trgzng1802/LED-CUB-8x8x8-using-STM32/README.md

# LED-CUB-8x8x8-using-STM32
Đề tài báo cáo cuối khoá C22
Ngày báo cáo: 19/06/2022

************************
Folder: "altium" chứa file schematic của CUBE.
Folder: "code ledcube" chứa toàn bộ code + config của CUBE.
Folder: "code stm32f0" + "test 74hc595" chứa file code + config test SN74HC595N.
Folder: "proteus" chứa file mô phỏng.

************************
GamoLedCube là tool mô phỏng cube.
