trgzng1802/LED-CUB-8x8x8-using-STM32/board.DXF

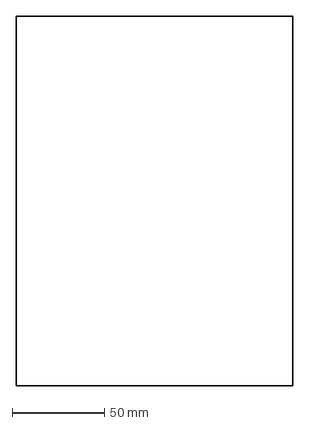
[picture p3: CAD file, 2022-07-10]
board.DXF
150.0 x 200.0 mm
