trgzng1802/LED-CUB-8x8x8-using-STM32/altium/schematic_board_ledcube.pdf

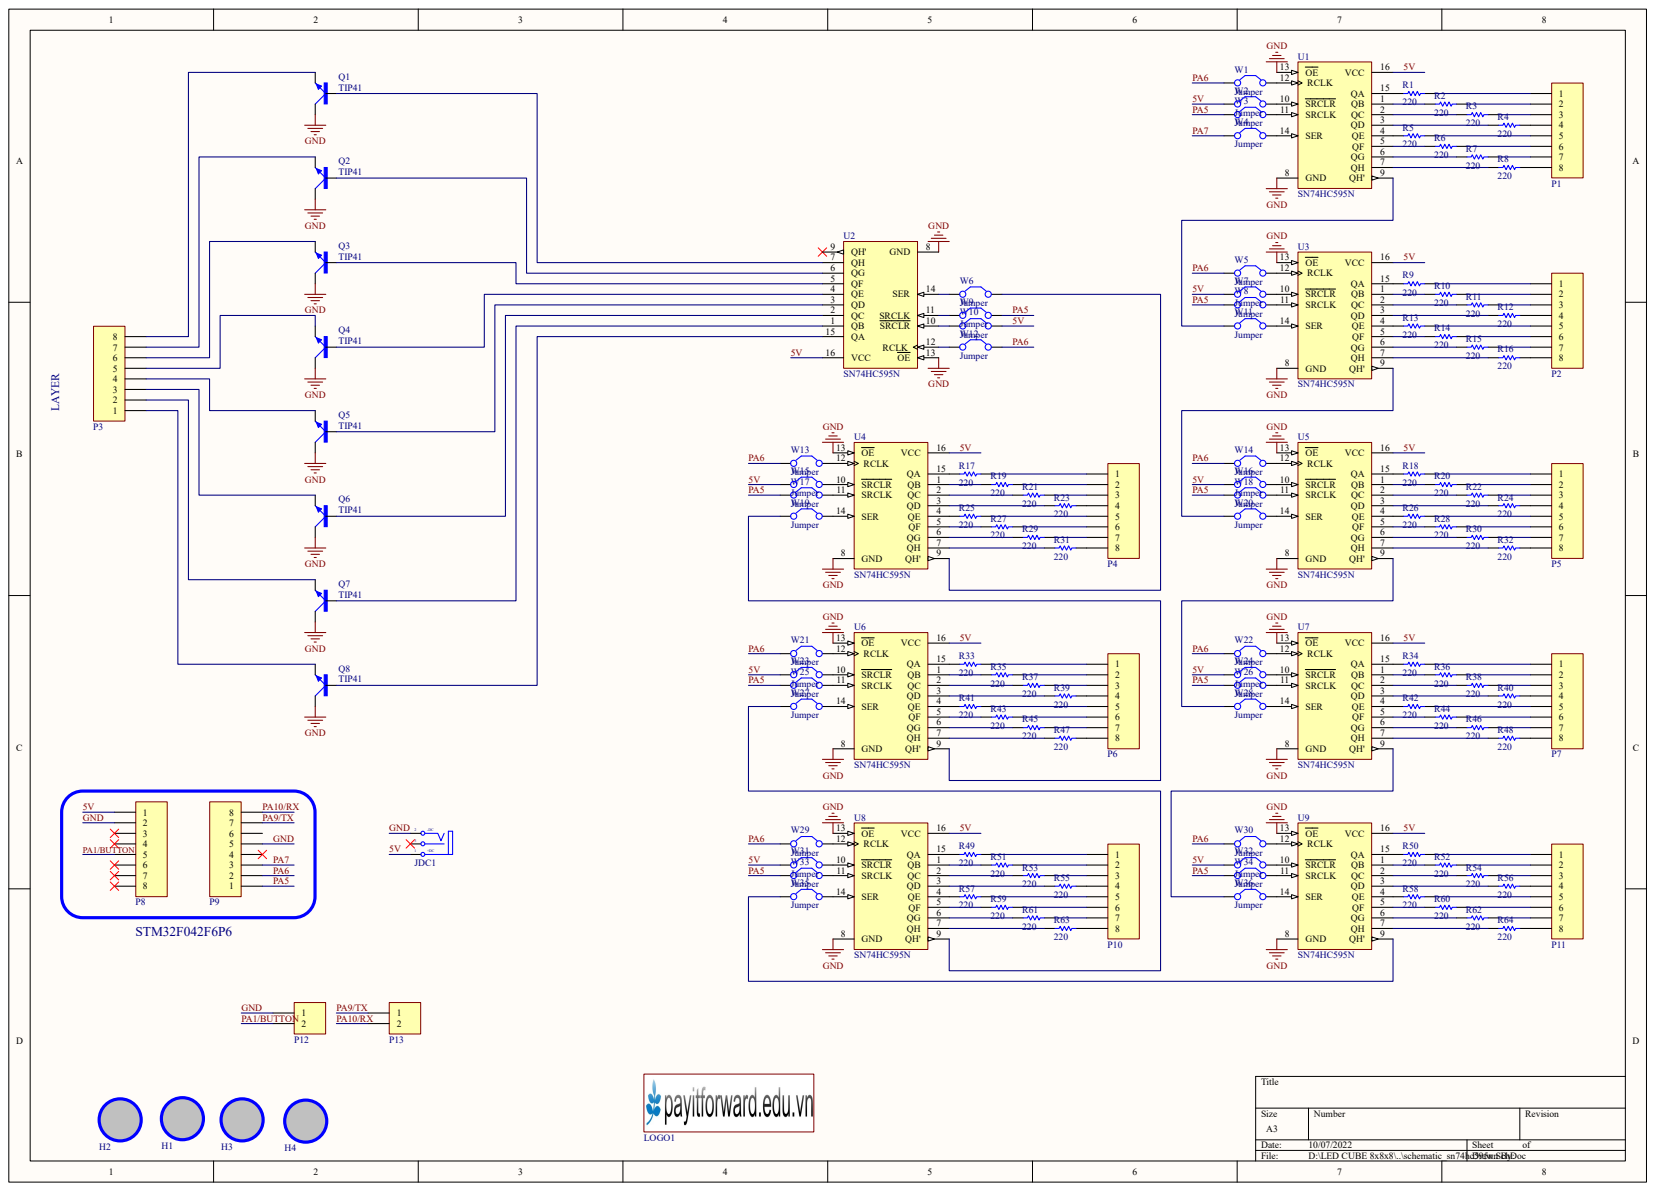
[picture p4: page 1]
