trgzng1802/LED-CUB-8x8x8-using-STM32/altium/schematic_sn74hc595n.pdf

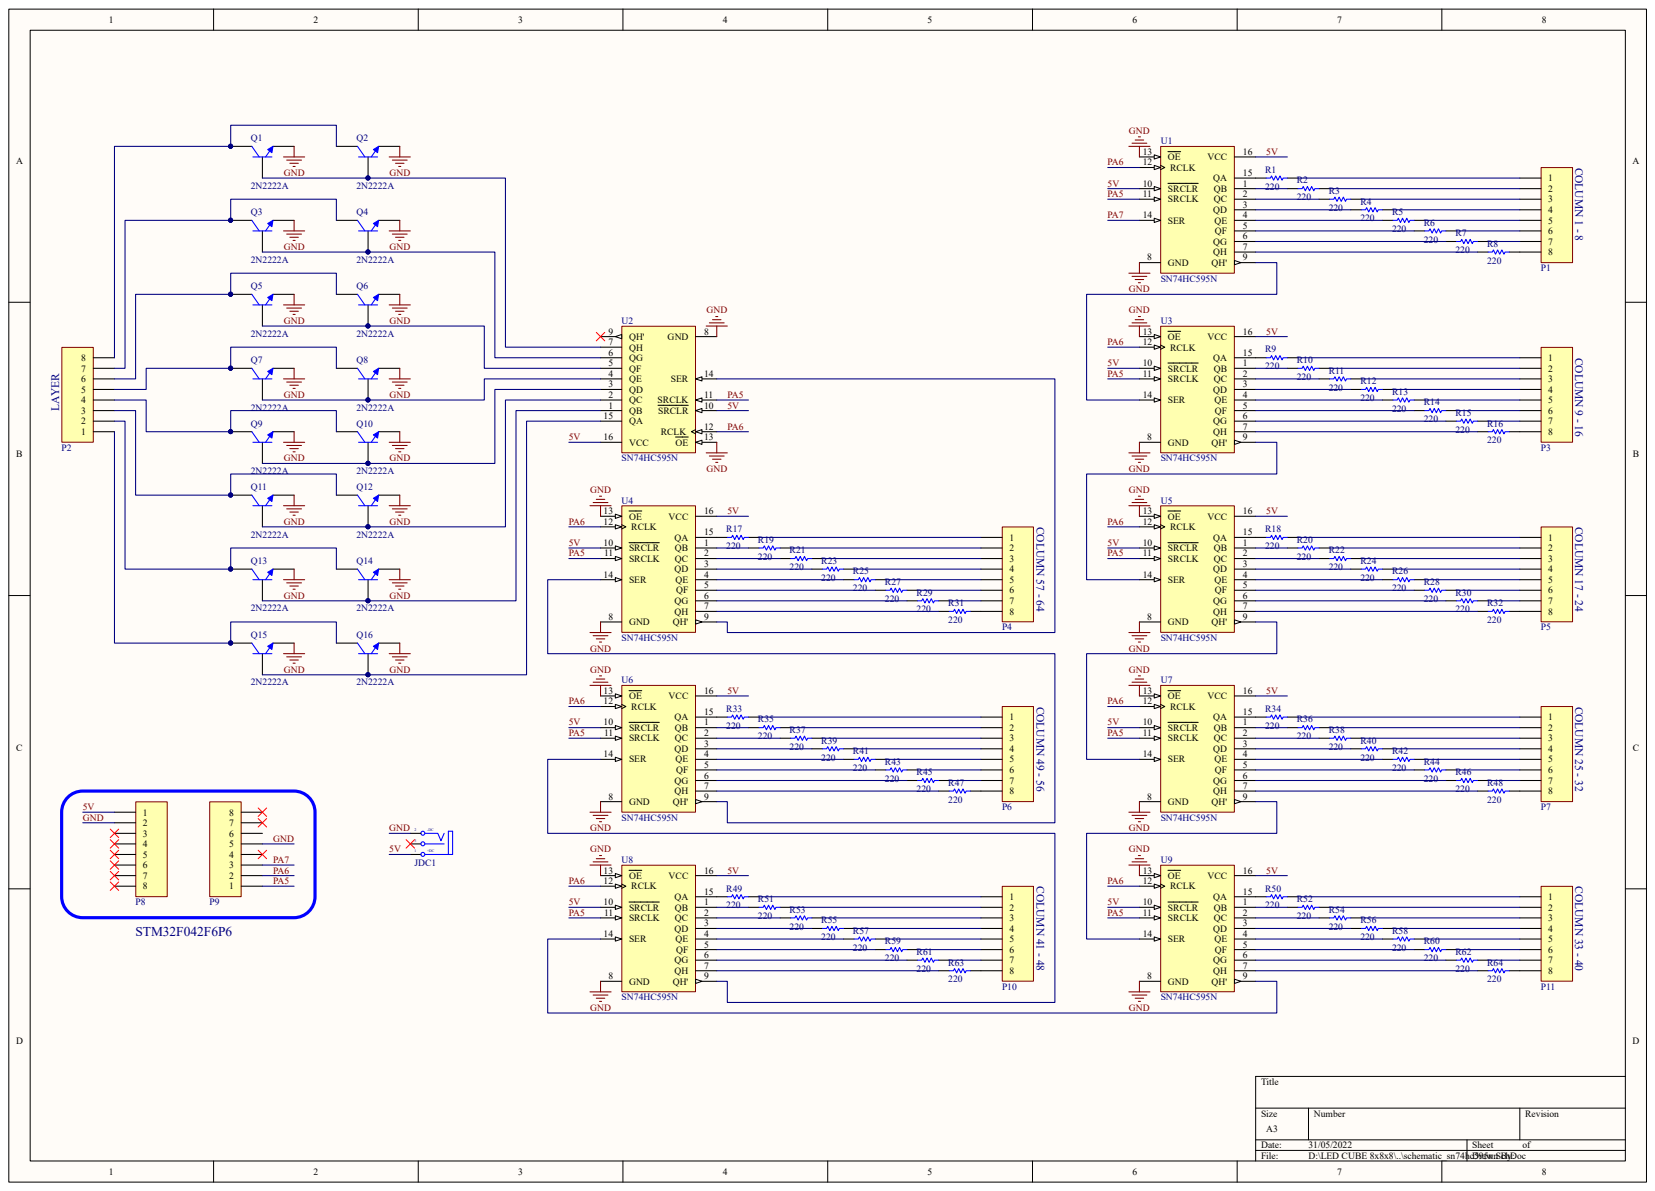
[picture p5: page 1]
