trgzng1802/LED-CUB-8x8x8-using-STM32/altium/chancube.pdf

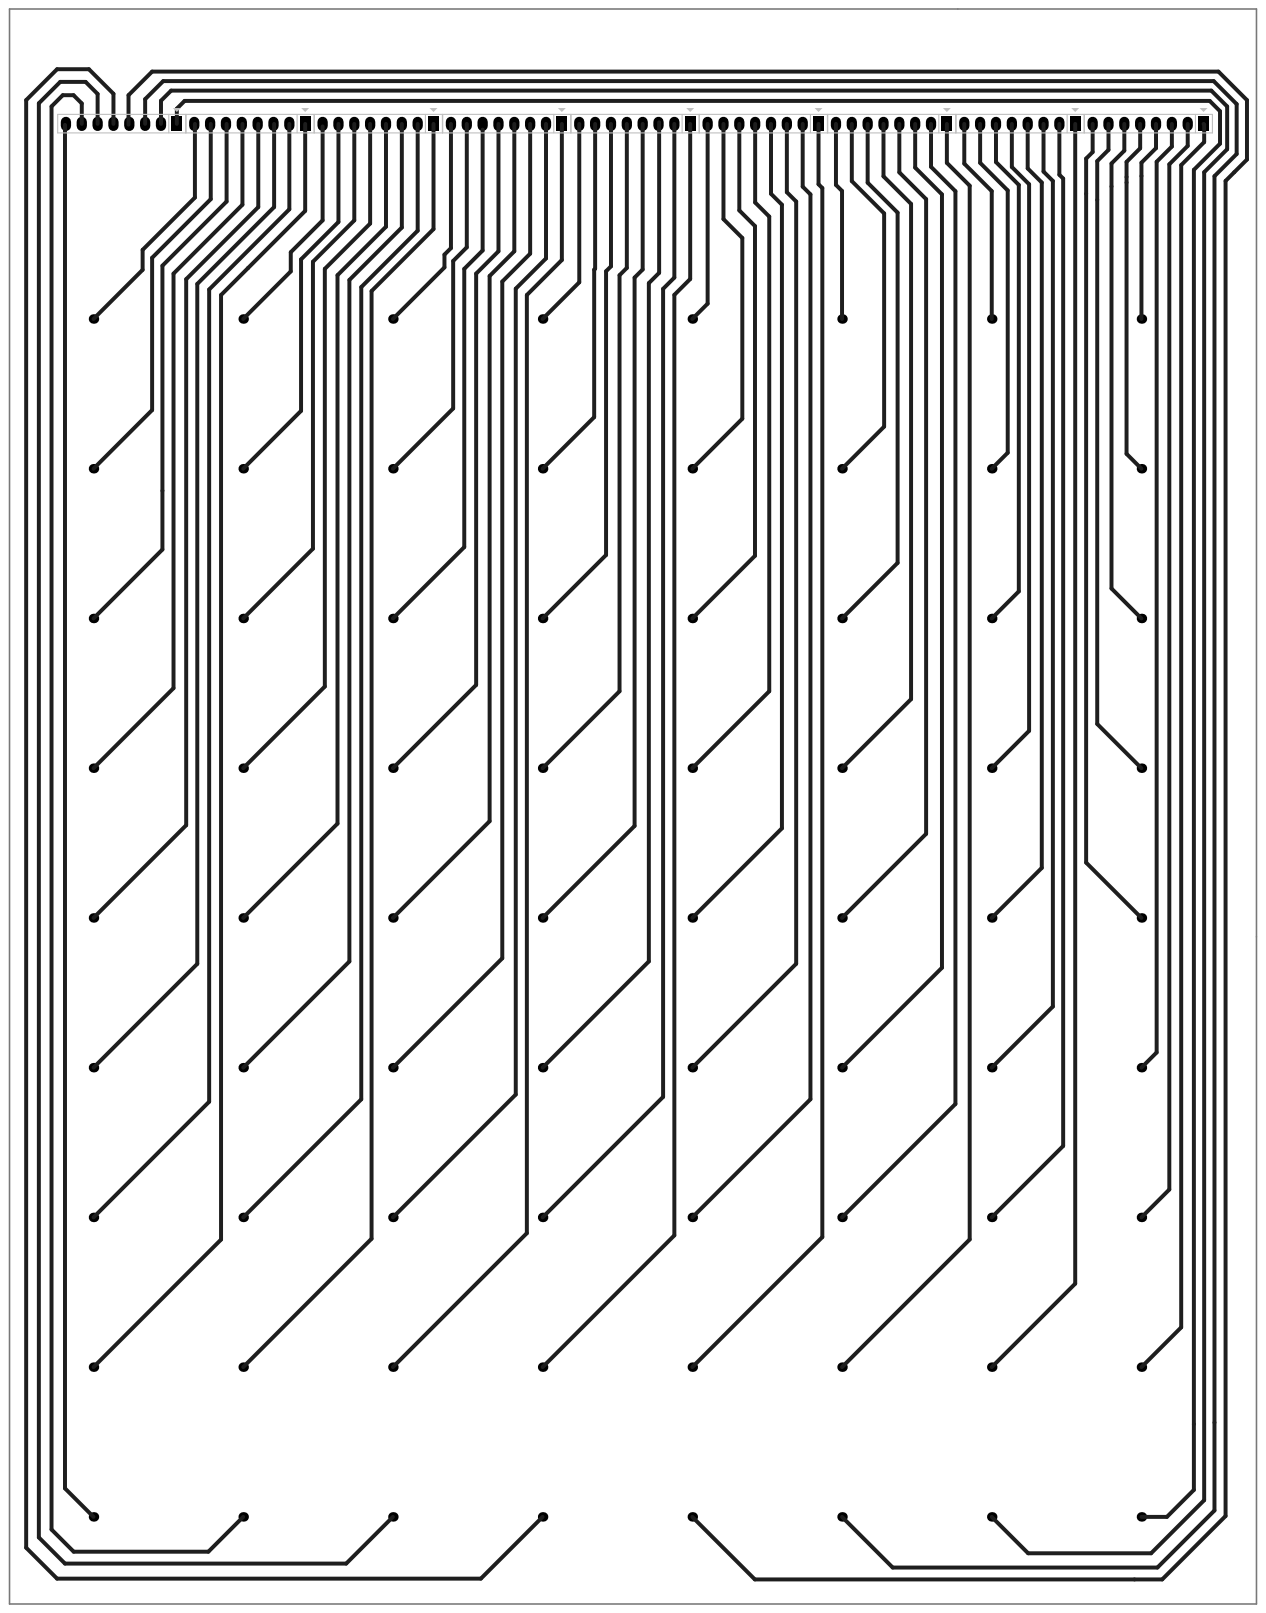
[picture p6: page 1]
