trgzng1802/LED-CUB-8x8x8-using-STM32/altium/chnacube.pdf

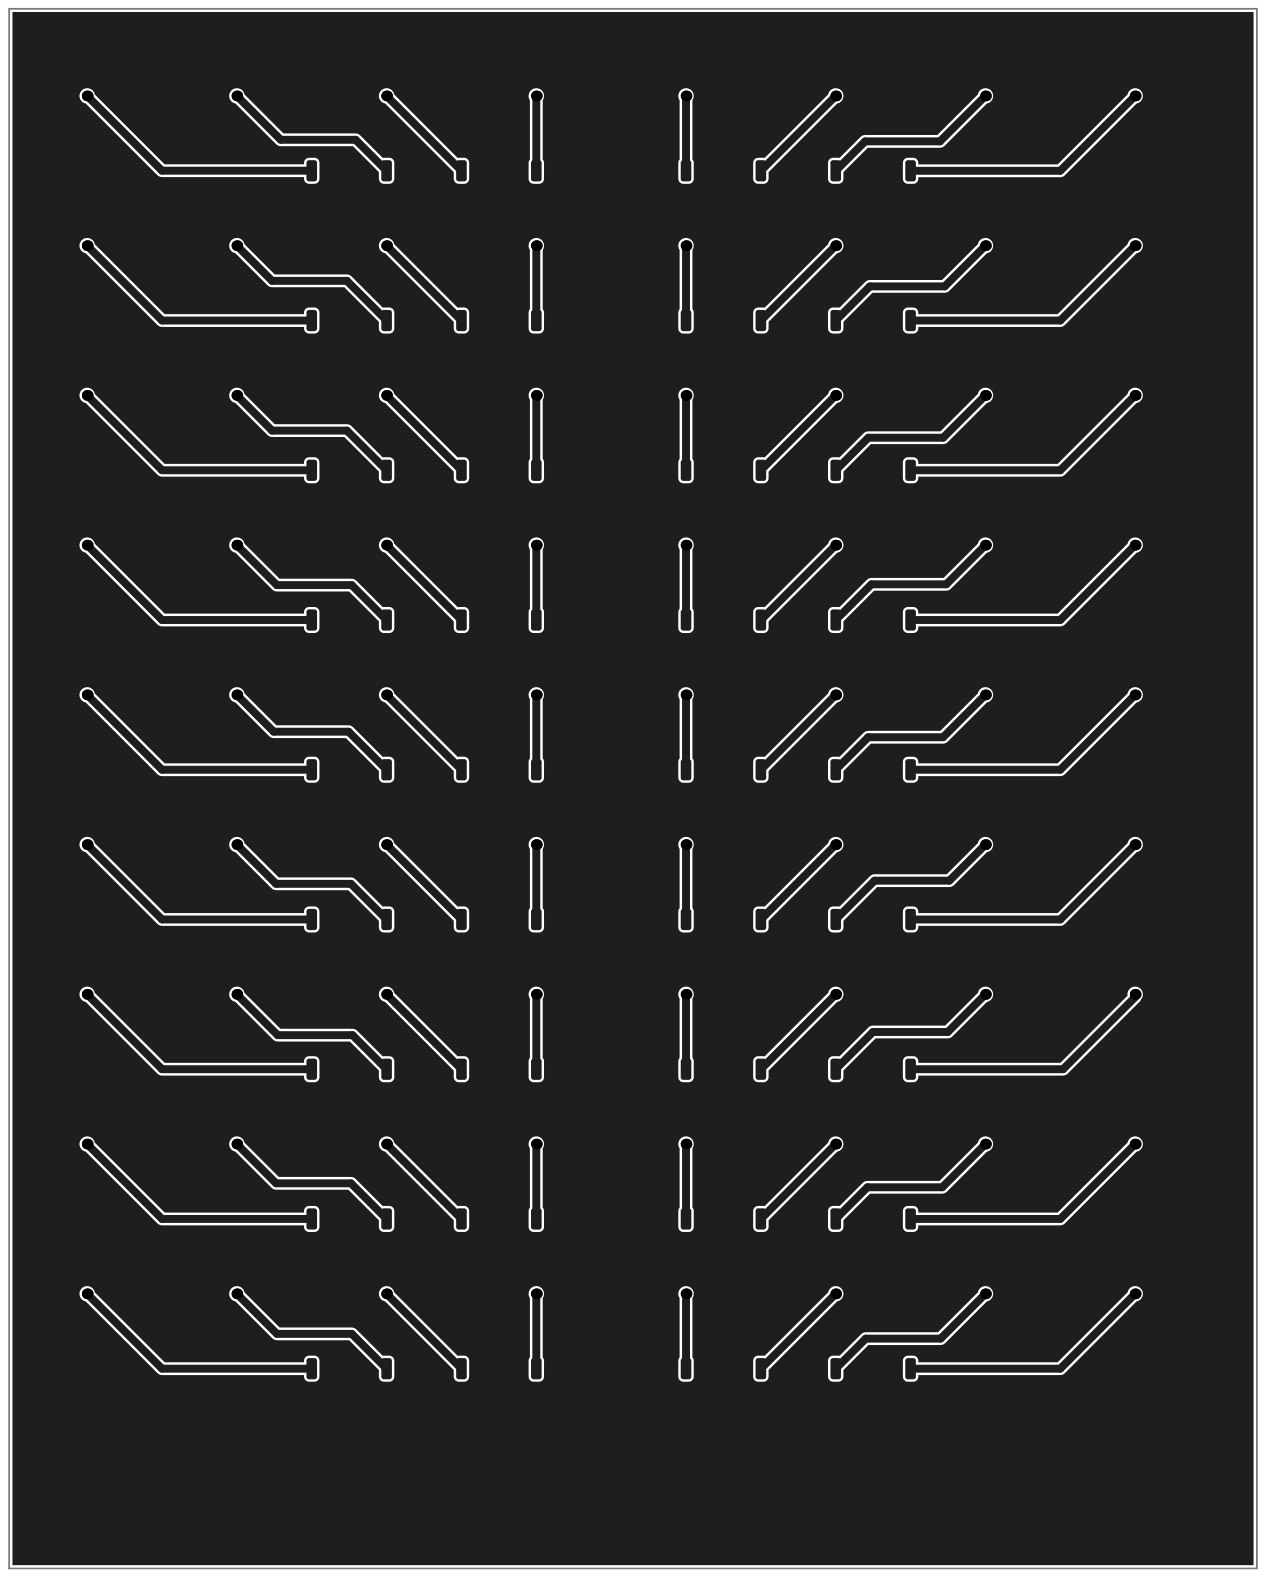
[picture p7: page 1]
