trgzng1802/LED-CUB-8x8x8-using-STM32/(list of files, drawings)

Other design files:
altium/LED_CUBE.PrjPCB
altium/schematic_sn74hc595n.PcbDoc
altium/schematic_sn74hc595n.SchDoc
proteus/16leds.pdsprj
proteus/example.pdsprj
