trgzng1802/LED-CUB-8x8x8-using-STM32/code ledcube/Core/Src/main.c

/* Includes ------------------------------------------------------------------*/
#include "main.h"

/* USER CODE BEGIN Includes */

#include "led_cube_handle.h"
/* USER CODE END Includes */


/* USER CODE BEGIN PV */
SPI_HandleTypeDef hspi1;
UART_HandleTypeDef huart1;
uint8_t rxData;
Btn_Typedef button1;
/* USER CODE END PV */

void SystemClock_Config(void);
static void MX_GPIO_Init(void);
static void MX_SPI1_Init(void);
static void MX_USART1_UART_Init(void);
/* USER CODE BEGIN PFP */
void HAL_UART_RxCpltCallback(UART_HandleTypeDef *huart);
/* USER CODE END PFP */

/* USER CODE BEGIN 0 */
void HAL_UART_RxCpltCallback(UART_HandleTypeDef *huart)
{
	if (huart->Instance == huart1.Instance)
	{
		HAL_UART_Receive_IT(&huart1, &rxData, 1);
		currentEffect = rxData - 48;
	}
}
/* USER CODE END 0 */

/**
  * @brief  The application entry point.
  * @retval int
  */
int main(void)
{
  /* MCU Configuration--------------------------------------------------------*/

  /* Reset of all peripherals, Initializes the Flash interface and the Systick. */
  HAL_Init();

  /* USER CODE BEGIN Init */

  Btn_Init(&button1, GPIOA, GPIO_PIN_1);
  /* USER CODE END Init */

  /* Configure the system clock */
  SystemClock_Config();

  /* Initialize all configured peripherals */
  MX_GPIO_Init();
  MX_SPI1_Init();
  MX_USART1_UART_Init();
  /* USER CODE BEGIN 2 */
  HAL_UART_Receive_IT(&huart1,&rxData, 1);
  /* USER CODE END 2 */

  /* Infinite loop */
  /* USER CODE BEGIN WHILE */
  while (1)
  {
    /* USER CODE END WHILE */

    /* USER CODE BEGIN 3 */
	  Btn_Handle(&button1);
	  Led_cube_Handle(currentEffect);
//	  for (int i = 0; i < 8; i++)
//	  {
//		  for (int j = 0; j < 8; j++)
//		  {
//			  for (int k = 0; k < 8; k++)
//			  {
//				  DisplayLed(k, j, i, hspi1, 0);
//
//				  HAL_Delay(100);
//			  }
//		  }
//	  }
  }
  /* USER CODE END 3 */
}

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
