trgzng1802/LED-CUB-8x8x8-using-STM32/code ledcube/cube8.ioc

Mcu.UserName=STM32F042F6Px
PA1.Signal=GPIO_Input
PA10.Signal=USART1_RX
PA13.Signal=SYS_SWDIO
PA14.Signal=SYS_SWCLK
PA5.Signal=SPI1_SCK
PA6.GPIO_Label=LATCH_PIN
PA6.Signal=GPIO_Output
PA7.Signal=SPI1_MOSI
PA9.Signal=USART1_TX
PF0-OSC_IN.Signal=RCC_OSC_IN
PF1-OSC_OUT.Signal=RCC_OSC_OUT
