trgzng1802/LED-CUB-8x8x8-using-STM32/(commit log)

2022-06-19 da fix hieu ung sang cac canh va duong cheo cube
    [main.c]
2022-06-21 fix hieu ung mua
    [main.c]
2022-06-28 update them uart + sua hieu ung
2022-07-05 state machine
    [cube8 Debug.cfg]
2022-07-10 updata schematic
    [LED_CUBE.PrjPCB, board.DXF, schematic_sn74hc595n.PcbDoc, schematic_sn74hc595n.SchDoc]
